nadeenJaber509/BirTics-WRO-2026/docs/README.md

# 📚 Documentation

This directory contains the engineering documentation for the **BirTics WRO Future Engineers 2026** project.

Each section documents a different aspect of the robot's development, from the initial engineering decisions to the current implementation and testing progress.

## Contents

| Section | Description |
|---|---|
| [⚙️ **Mechanical Design**](mechanical-design/README.md) | Chassis design, hardware selection, component placement, and mechanical decisions. |
| [🔋 **Power & Sensors**](power-and-sensors/README.md) | Electrical architecture, wiring, power distribution, and sensor integration. |
| [💻 **Software Architecture**](software-architecture/README.md) | Software structure, algorithms, navigation logic, and control strategy. |
| [📖 **Engineering Journey**](engineering-journal.md) | Chronological record of design decisions, development milestones, and engineering progress. |
| [🧪 **Testing**](testing/README.md) | Hardware and software validation, subsystem testing, and integration results. |
| [👥 **Team Roles**](team-roles.md) | Team responsibilities, collaboration, and project organization. |
