nadeenJaber509/BirTics-WRO-2026/docs/software-architecture/README.md

# 💻 Software Architecture

Welcome to the **Software Architecture** section of the **BirTics WRO Future Engineers 2026** repository.

This directory contains the software design, system architecture, navigation strategy, control algorithms, and implementation documentation for our autonomous vehicle developed for the WRO Future Engineers 2026 competition.

Each document explains a specific part of the robot software, from sensor processing and decision making to vehicle control and autonomous navigation.

---

# 📂 Documentation

| Document | Description |
|---|---|
| 🧠 [Algorithms Plan](algorithms_plan.md) | Complete autonomous driving algorithm and overall software workflow. |
| ⚙️ [ESP32 Software Strategy](esp32_software_strategy.md) | Software architecture implemented on the ESP32 microcontroller. |
| 🛣️ [Lane Following Design](lane_following_design.md) | Detection of lane boundaries and steering strategy using the two color sensors. |
| 🚧 [Obstacle Avoidance Strategy](obstacle_avoidance_strategy.md) | Obstacle detection using the three ToF sensors and the corresponding avoidance logic. |
| 🎯 [PID Controller](pid_controller.md) | Steering PID controller used to improve driving stability and lane tracking. |
| 📡 [Sensor Requirements](sensor_requirements.md) | Description of all sensors, their roles, and software interface requirements. |
| 🔄 [Software Flowchart](software_flowchart.md) | Overall execution flow of the autonomous driving software. |
| 📚 [Software Research Notes](software_research_notes.md) | Design decisions, software experiments, and implementation references collected during development. |
| 🔀 [State Machine](state_machine.md) | Robot operating states and transitions throughout the competition run. |

---

# 📌 Purpose

The goal of this documentation is to describe the software architecture developed for the BirTics autonomous vehicle and explain how each software module contributes to autonomous operation.

The documentation covers:

- Overall software architecture
- Sensor integration
- Lane following
- Obstacle detection and avoidance
- Vehicle control
- Decision-making process
- State machine implementation
- ESP32 software organization

---

<div align="center">

## BirTics – WRO Future Engineers 2026

**Software Architecture Documentation**

</div>
