nadeenJaber509/BirTics-WRO-2026/docs/team-roles.md

<!-- ═══════════════════════════════════════════════════════════════════════════
     BirTics · WRO Future Engineers 2026 · Team Roles
     ═══════════════════════════════════════════════════════════════════════════ -->

<div align="center">

```
╔══════════════════════════════════════════════════════════╗
║                                                          ║
║         T H E   B I R T I C S   T E A M                 ║
║                                                          ║
║           Three Engineers. One Robot.                    ║
║                                                          ║
╚══════════════════════════════════════════════════════════╝
```





<br/>

*Clear roles, shared decisions, and one integrated autonomous vehicle.*

</div>

---

## 🗺️ Quick Navigation

| Section | Description |
| --- | --- |
| [👥 Team Overview](#-team-overview) | Team structure and shared objective |
| [💻 Julnar Assi — Software Lead](#-julnar-assi--software-lead) | Software, perception, and control |
| [⚙️ Lana Sayes — Mechanical Lead](#️-lana-sayes--mechanical-lead) | Chassis, steering, and assembly |
| [📋 Nadeen Jaber — Documentation & Testing Lead](#-nadeen-jaber--documentation--testing-lead) | GitHub, documentation, planning, and testing |
| [🔗 Collaboration](#-collaboration) | How responsibilities are coordinated |

---

## 👥 Team Overview

BirTics is a team of three engineering students from **Birzeit University, Palestine**, participating in the **WRO Future Engineers 2026** competition.

Each member has a primary responsibility, while major decisions are reviewed by the entire team.
Although responsibilities are divided, subsystem integration and major engineering decisions are discussed collaboratively to ensure consistency across the complete robot.

| Member | Primary Role | Main Focus |
| --- | --- | --- |
| Julnar Assi  | Software Lead | Perception, algorithms, control, integration |
| Lana Sayes | Mechanical Lead | Chassis, steering, assembly, hardware placement  |
| Nadeen Jaber | Documentation & Testing Lead | Planning, GitHub, documentation, testing records |

```text
Julnar: Software and control
             │
             ▼
        BirTics Robot
             ▲
             │
Lana: Mechanical design

Nadeen: Documentation, planning, and testing
```

The three roles are connected because every software, hardware, and testing decision affects the complete vehicle.

---

## 💻 Julnar Assi — Software Lead

### Role

Julnar leads the design, implementation, and integration of the robot's software.

### Main Responsibilities

| Responsibility | Description |
| --- | --- |
| **Sensor Processing** | Reading and interpreting data from the robot's sensors |
| **Navigation Logic** | Developing the logic used to follow the track and complete laps |
| **Obstacle Handling** | Implementing behavior for red and green traffic signs |
| **Motion Control** | Generating commands for driving and steering |
| **Software Integration** | Combining software modules into one working control system |
| **Code Testing** | Debugging, tuning, and validating software behavior |

### Software Flow

```text
Sensor Input
     │
     ▼
Data Processing
     │
     ▼
Environment Interpretation
     │
     ▼
Decision Logic
     │
     ▼
Motor and Steering Commands
```

### Main Deliverables

* Robot control code
* Sensor-reading modules
* Navigation and obstacle-handling logic
* Motion-control functions
* Software testing results
* Documented and commented source code

---

## ⚙️ Lana Sayes — Mechanical Lead

### Role

Lana leads the physical design, assembly, and mechanical integration of the vehicle.

### Main Responsibilities

| Responsibility | Description |
| --- | --- |
| **Chassis Design** | Defining the vehicle's structure, geometry, and dimensions |
| **Steering System** | Designing and adjusting the steering mechanism |
| **Mechanical Assembly** | Building and securing the vehicle components |
| **Component Placement** | Positioning motors, sensors, battery, and controller |
| **Structural Reliability** | Checking balance, strength, clearance, and stability |
| **Physical Testing** | Evaluating movement, turning, and mechanical performance |

### Mechanical Flow

```text
Competition Constraints
        │
        ▼
Chassis Design
        │
        ▼
Steering and Wheel Setup
        │
        ▼
Component Placement
        │
        ▼
Assembly
        │
        ▼
Physical Testing
```

### Main Deliverables

* Chassis design and assembly
* Steering mechanism
* Component-mounting solution
* Mechanical diagrams and photos
* Physical test results
* Records of mechanical changes and improvements

---

## 📋 Nadeen Jaber — Documentation & Testing Lead

### Role

Nadeen manages the project's documentation, GitHub organization, planning, and structured testing records.

### Main Responsibilities

| Responsibility | Description |
| --- | --- |
| **GitHub Management** | Organizing files, folders, links, commits, and documentation |
| **Engineering Journal** | Recording development sessions, decisions, and progress |
| **Technical Documentation**  | Maintaining hardware, software, testing, and design documents |
| **Project Planning** | Tracking tasks, milestones, responsibilities, and deadlines |
| **Testing Coordination** | Preparing test plans and organizing test sessions |
| **Results Logging** | Recording expected results, actual results, failures, and fixes |
| **Presentation Preparation** | Preparing judge-facing materials and project summaries |

### Documentation Flow

```text
Team Activity
     │
     ▼
Engineering Journal
     │
     ▼
Test Records
     │
     ▼
Technical Documentation
     │
     ▼
GitHub Repository
     │
     ▼
Judge-Ready Project Record
```

### Main Deliverables

* Organized GitHub repository
* Engineering journal
* Testing plans and results
* Hardware and software documentation
* Team progress records
* Presentation and competition materials

---

## 🔗 Collaboration

Although each member has a primary role, the team collaborates on decisions that affect more than one subsystem.

| Decision or Task | Lead | Support |
| --- | --- | --- |
| Software architecture | Julnar | Nadeen |
| Navigation and control | Julnar | Lana |
| Chassis and steering | Lana | Julnar |
| Sensor placement | Lana and Julnar | Nadeen |
| Hardware selection | All members | — |
| Test-plan design | Nadeen | Julnar and Lana |
| Test execution | All members | — |
| Engineering documentation | Nadeen | Julnar and Lana |
| Competition presentation  | Nadeen | All members |

### Collaboration Principles

* Each task has one clear lead.
* Major technical decisions are discussed by the whole team.
* Every important change is documented.
* Testing is shared by all members.
* Documentation must match the actual robot.
* Problems and failed tests are recorded, not hidden.

---

## Team Responsibility Summary

```text
SOFTWARE
Julnar
- Sensor processing
- Navigation logic
- Motion control
- Software integration

MECHANICAL
Lana
- Chassis
- Steering
- Assembly
- Component placement

DOCUMENTATION AND TESTING
Nadeen
- GitHub
- Engineering journal
- Test coordination
- Project planning
```

Together, the three roles form one integrated engineering workflow:

```text
Mechanical Design
        +
Embedded Software
        +
Documentation & Validation
        =
BirTics Autonomous Vehicle
```

---

<div align="center">

```
━━━━━━━━━━━━━━━━━━━━━━━━━━━━━━━━━━━━━━━━━━━━━━━━━━━━━━━━━━━
  B I R T I C S  ·  W R O  F U T U R E  E N G I N E E R S
              From Sketches to Autonomy
         Birzeit University · Palestine · 2026
━━━━━━━━━━━━━━━━━━━━━━━━━━━━━━━━━━━━━━━━━━━━━━━━━━━━━━━━━━━
```

[← Back to Main Repository](../README.md)
 · 
[Engineering Journal →](engineering-journal.md)
 · 
[Our Story →](story-portfolio/team-story.md)

</div>
