nadeenJaber509/BirTics-WRO-2026/docs/mechanical-design/README.md

# ⚙️ Mechanical Design

Welcome to the **Mechanical Design** section of the **BirTics WRO Future Engineers 2026** repository.

This directory contains all documentation related to the robot's mechanical architecture, hardware selection, and supporting engineering documents.

Use the links below to navigate through the available documents.

---

# 📂 Documents

| Document | Description |
|---|---|
| 📄 [Hardware Distribution & Selection](WRO_2026_BirTics_Hardware_Distribution_and_Selection_V1.pdf) | Original engineering document describing the selected hardware architecture, component placement, build order, and engineering rationale. |
| 💰 [Robot Parts Cost & Selection Rationale](WRO_2026_Robot_Parts_Cost_and_Selection_Rationale.pdf) | Cost analysis, component pricing, quantities, and selection justification. |

---

# 📌 Purpose

The documents in this section describe:

- Mechanical architecture
- Hardware selection
- Component placement
- Build sequence
- Cost estimation
- Engineering justification

<div align="center">

**BirTics – WRO Future Engineers 2026**

*Mechanical Design Documentation*

</div>
