nadeenJaber509/BirTics-WRO-2026/assets/electronics/color-sensors.JPG

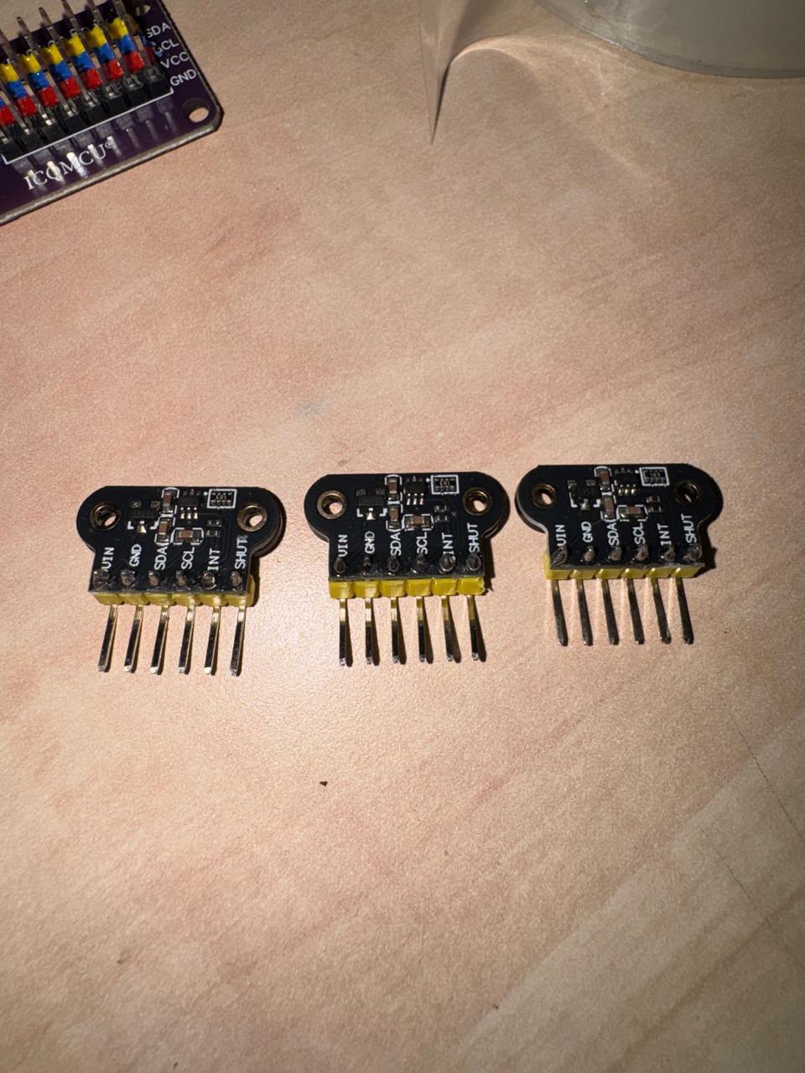
assets/electronics/color-sensors.JPG
