nadeenJaber509/BirTics-WRO-2026/docs/testing/TestingSteps.png

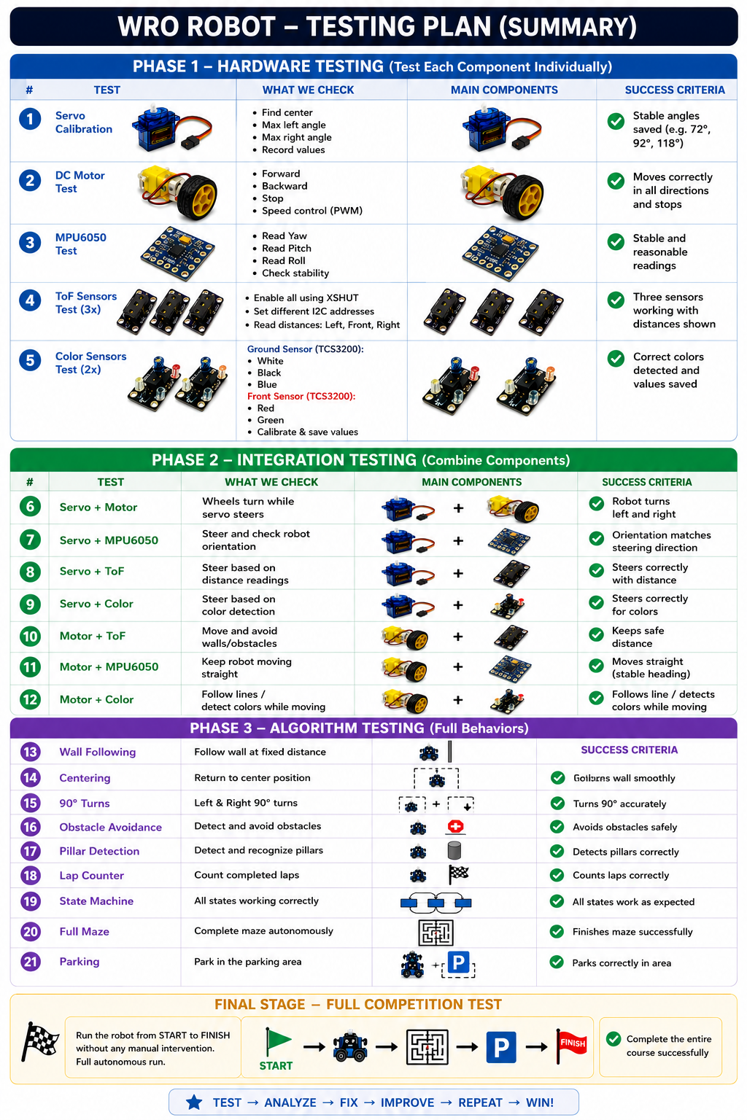
docs/testing/TestingSteps.png
