nadeenJaber509/BirTics-WRO-2026/(commit log)

2026-05-31 Add power and sensor documentation
2026-05-31 Enhance README
    Added a flowchart to illustrate the BirTics development journey.
2026-05-31 read me
    Removed the Development Roadmap and Current Phase sections from the README.
2026-06-03 Enhance README with project details and structure
    Expanded the README to include detailed project vision, development stages, and current project status. Added sections for team introduction, engineering journey timeline, and repository map.
2026-06-15 Add initial software research notes
    Documented software architecture research notes including lane detection, color detection, PID control, and state machine design.
2026-06-15 Add algorithms plan for driving and obstacle strategy
    Documented algorithms for lane following, PID steering, pillar detection, obstacle avoidance, lap counting, and parking strategy.
2026-06-15 Add sensor requirements for software implementation
2026-06-15 Add software flowchart for autonomous driving logic
2026-06-20 Add PID steering controller documentation
    This document outlines the purpose, functionality, and testing plan for the PID steering controller used in robot navigation.
2026-06-20 Add lane following design documentation
    Document the design of the lane following algorithm, including its purpose, sensor inputs, methods, challenges, and testing plan.
2026-06-20 Add obstacle avoidance strategy documentation
    Document the obstacle avoidance strategy for the robot, detailing detection methods, strategies for red and green pillars, safety conditions, state machine integration, testing plans, and current status.
2026-06-23 Add ESP32-only software strategy
    This document outlines the software strategy for utilizing the ESP32 as the main controller for the robot, detailing hardware inputs and outputs, software modules, and driving strategies.
2026-06-23 Create sensor abstraction module
2026-06-23 Create PID controller module
2026-06-24 Connect main program with sensors, PID, and state machine
    Added sensor reading and PID control for lane following.
2026-06-24 Update sensor module for three LiDAR sensors
2026-06-24 Update main program to use LiDAR sensor readings
    Fix indentation issue in main function call
2026-06-24 Create lane following module using LiDAR and PID
    Implement lane following logic using PID controller.
2026-07-07 Revise README for ESP32 robot software
    Updated README to reflect ESP32 Arduino code structure and planned modules.
2026-07-07 Create initial ESP32 Arduino project
    Initial implementation of the main program for the BirTics WRO 2026 ESP32 robot, including setup and loop functions.
2026-07-07 Add ESP32 configuration header
2026-07-07 Add sensor module header
2026-07-07 Add sensor module implementation
2026-07-11 Update engineering journal with project progress
    Expanded the engineering journal to document the team's journey, including project initialization, prototype development, design evolution, and preparation for the trial competition.
2026-07-11 Revise figures and captions in engineering journal
    Updated figures and descriptions for the prototype evaluation in the engineering journal.
2026-07-12 Document ToF sensor integration and trial competition focus
    Added a section on Time-of-Flight sensor integration and updated the trial competition preparation details.
2026-07-12 Document ToF sensor integration with ESP32
    Added details about integrating Time-of-Flight sensors with the ESP32 controller, including focus areas and an image for reference.
2026-07-15 Add single VL6180X Time-of-Flight sensor test
2026-07-15 Add test for three VL6180X sensors on ESP32
    This file contains a test program for three VL6180X Time-of-Flight sensors using shared I2C bus on an ESP32. It initializes the sensors, assigns I2C addresses, and continuously reads and prints distance measurements.
2026-07-15 improve ESP32 documentation
2026-07-15 Enhance testing and validation documentation
    Expanded the testing documentation to include validation processes, testing philosophy, current progress, and future testing plans for the BirTics WRO 2026 robot.
2026-07-15 Add wiring documentation for robot prototype
    This document summarizes the electrical connections for the robot prototype, detailing connections for the main controller, sensors, and motor driver.
2026-07-15 Refactor color sensor test for GPIO and pulse duration
    Updated the color sensor test to use GPIO 34 for output and modified pulse duration measurements. Changed frequency scaling to 2% for easier measurement.
2026-07-15 add robot prototype images
2026-07-15 Fix image file extension in wiring documentation
2026-07-15 Motor Driver testing
2026-07-15 Revise README for robot prototype documentation
    Updated README to include detailed documentation of the current robot prototype with images and descriptions.
2026-07-16 Revise engineering journal for hardware integration updates
    Updated the engineering journal to reflect changes in hardware integration and development progress, including new sections on acquiring hardware and current integration challenges.
2026-07-18 Rewrite algorithms plan for final robot design by changing the hardware components to what we used in the end
    Expanded the algorithms plan document to include detailed descriptions of the autonomous driving algorithms for the BirTics WRO Future Engineers 2026 robot, covering initialization, lane following, steering control, obstacle detection, and avoidance strategies.
2026-07-18 Rewrite sensor requirements for final hardware by changing the hardware components to what we used in the end
    Expanded the sensor requirements document to include detailed descriptions, purposes, and priorities for each sensor used in the BirTics WRO Future Engineers 2026 robot.
2026-07-18 Rewrite ESP32 software strategy with the updated hardware components
    Updated the ESP32 software strategy document to reflect changes in hardware inputs, outputs, and software modules. Revised sections for clarity and accuracy regarding the robot's control mechanisms and navigation strategies.
2026-07-18 Update lane following design
    Updated the lane following design document to clarify the purpose, main idea, and sensor inputs. Enhanced sections on lane position estimation, steering correction, and testing plan.
2026-07-18 Rewrite obstacle avoidance strategy
    Updated the obstacle avoidance strategy to enhance clarity on detection methods, avoidance strategies, and safety considerations. Revised testing plans and current status for better understanding.
2026-07-18 Rewrite PID controller documentation
    Refactor PID controller documentation for clarity and structure.
2026-07-18 Rewrite software flowchart
2026-07-18 Document the relationship between software design and ESP32 firmware
    Updated the README to clarify the software design and architecture for the BirTics WRO Future Engineers 2026 robot, including module descriptions and design philosophy.
2026-07-18 Replace multiplexer-based sensor model with three VL6180X and dual TCS3200 interfaces
    Refactor sensor reading functions and add type hints.
2026-07-18 Improve PID controller design with reset functionality and documentation
    Updated PID controller to use float for previous_error and integral.
2026-07-18 Replace LiDAR-based wall following with dual TCS3200 lane following design
    Updated lane following algorithm to use color sensor readings instead of distance measurements for error calculation and steering correction.
2026-07-19 Add wiring diagram section to README
    Added a section for the complete wiring diagram of the robot prototype.
2026-07-22 Update TOF ESP32 pin assignments for SHUT signals
